MobiFlight/mobiflight-pcbs/README.md

# mobiflight-pcbs
PCBs and breakout boards, designed by the MobiFlight community:

* [MobiFlight Prototyping Board](prototyping-board/README.md)
* [MobiFlight Multiplexer Breakout Board](breakout-multiplexer/README.md)
* [MobiFlight MAX7219 Breakout System](max7219-breakout-system/README.md)
* [MobiFlight MAX7219 Adapter Board](max7219-adapter/README.md)
* [MobiFlight Dual Encoder Board](dual-encoder-board/README.md)
* [MobiFlight LED Driver Board](led-driver-board/README.md)
* [MobiFlight PicoMega Board](picomega/README.md)
* [MobiFlight PicoMicro Board](picomicro/README.md)
* [MobiFlight PicoNano Board](piconano/README.md)
If you are missing information, or if you found a bug, please [create a new issue here on GitHub](https://github.com/MobiFlight/mobiflight-pcbs/issues/new).
