MobiFlight/mobiflight-pcbs/dimmer-board/README.md

# Light dimmer board

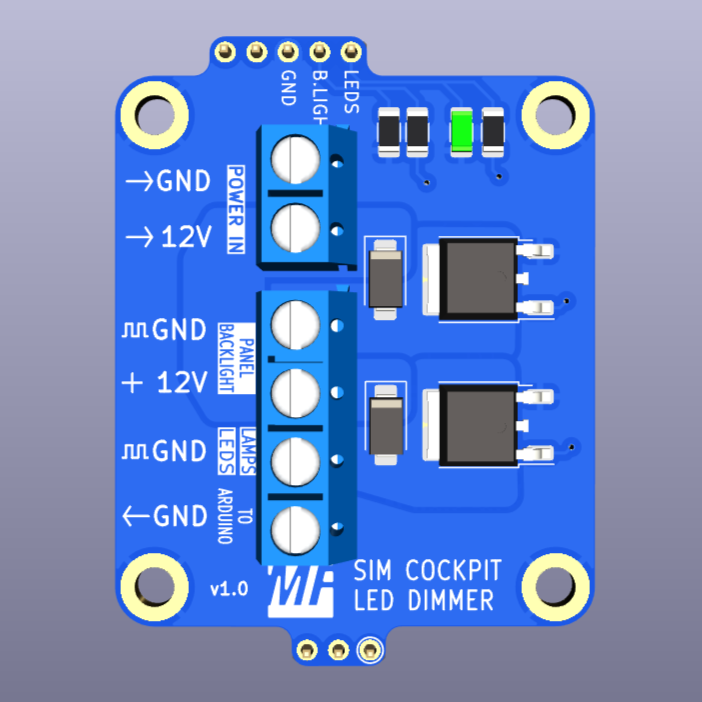
[picture p54: dimmer-board/dimmer-board.png]
Board image


This is a light dimmer board for backlight and cockpit lights, works as a shield on a full sized Arduino Mega, or standalone.
