MobiFlight/mobiflight-pcbs/dual-encoder-board/Encoder Dual Axis With Button EC11EBB24C03_2.png

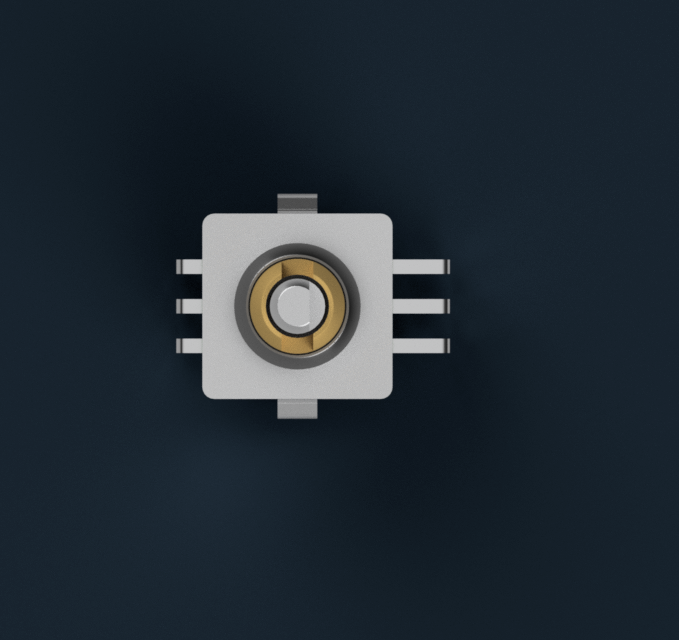
dual-encoder-board/Encoder Dual Axis With Button EC11EBB24C03_2.png
