MobiFlight/mobiflight-pcbs/dual-encoder-board/Encoder Single Axis With Button EC11M 25mm.png

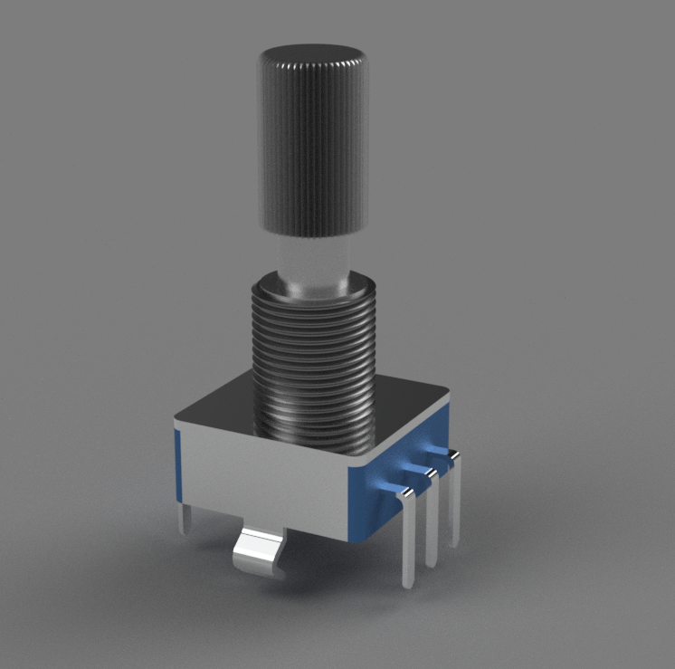
dual-encoder-board/Encoder Single Axis With Button EC11M 25mm.png
