MobiFlight/mobiflight-pcbs/max7219-breakout-digits/3-digits_0.36_Back.jpg

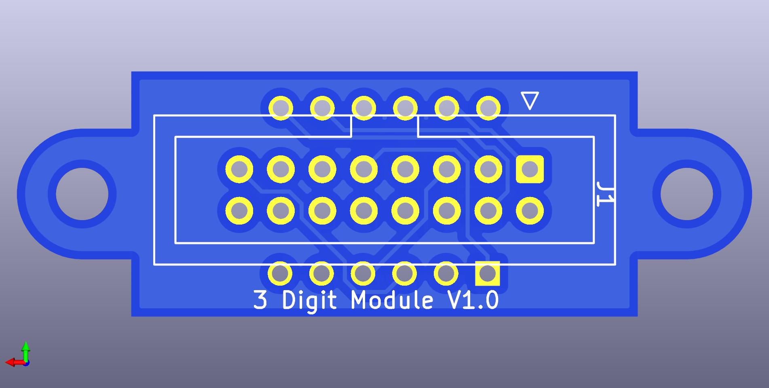
max7219-breakout-digits/3-digits_0.36_Back.jpg
