MobiFlight/mobiflight-pcbs/max7219-breakout-digits/4-digits_0.36_Back.jpg

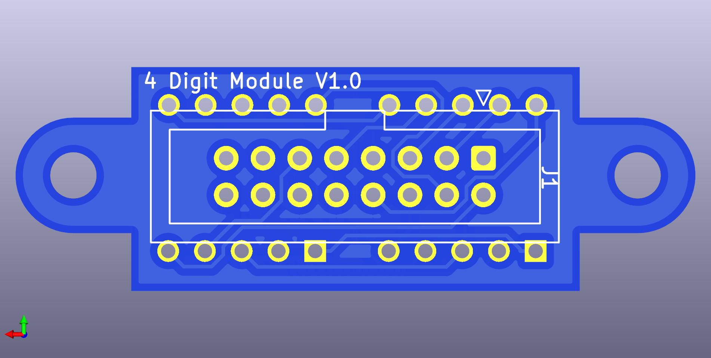
max7219-breakout-digits/4-digits_0.36_Back.jpg
