MobiFlight/mobiflight-pcbs/max7219-breakout-digits/5-digits_0.36_Front.jpg

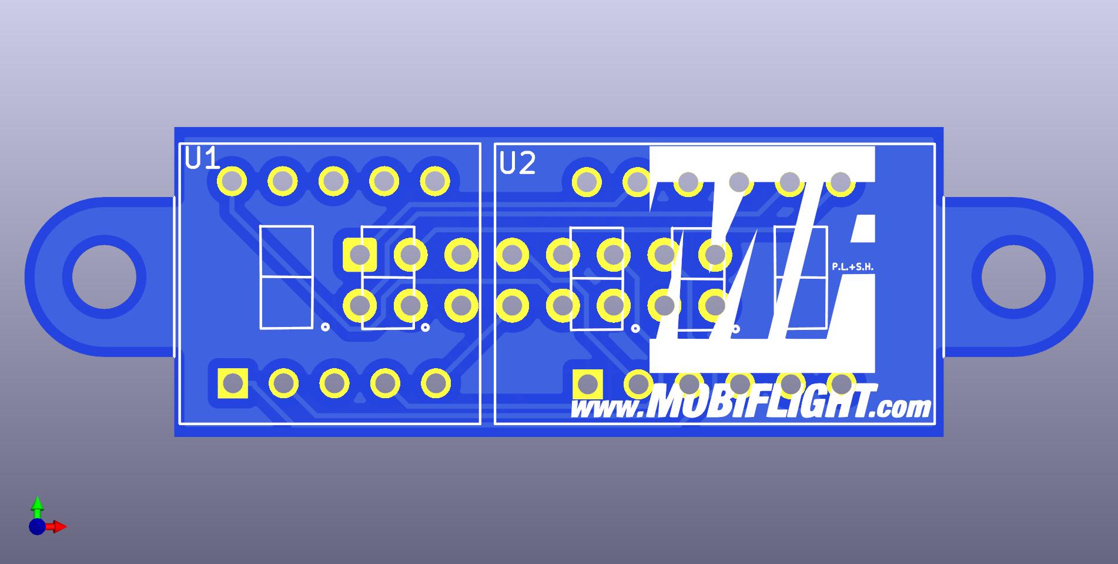
max7219-breakout-digits/5-digits_0.36_Front.jpg
