MobiFlight/mobiflight-pcbs/max7219-breakout-digits/6-digits_0.36_Back.jpg

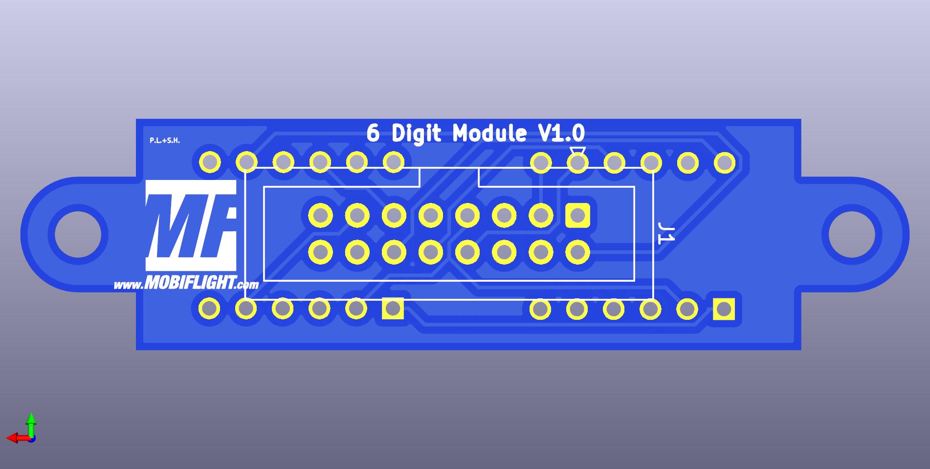
max7219-breakout-digits/6-digits_0.36_Back.jpg
