MobiFlight/mobiflight-pcbs/max7219-breakout-system/top.png

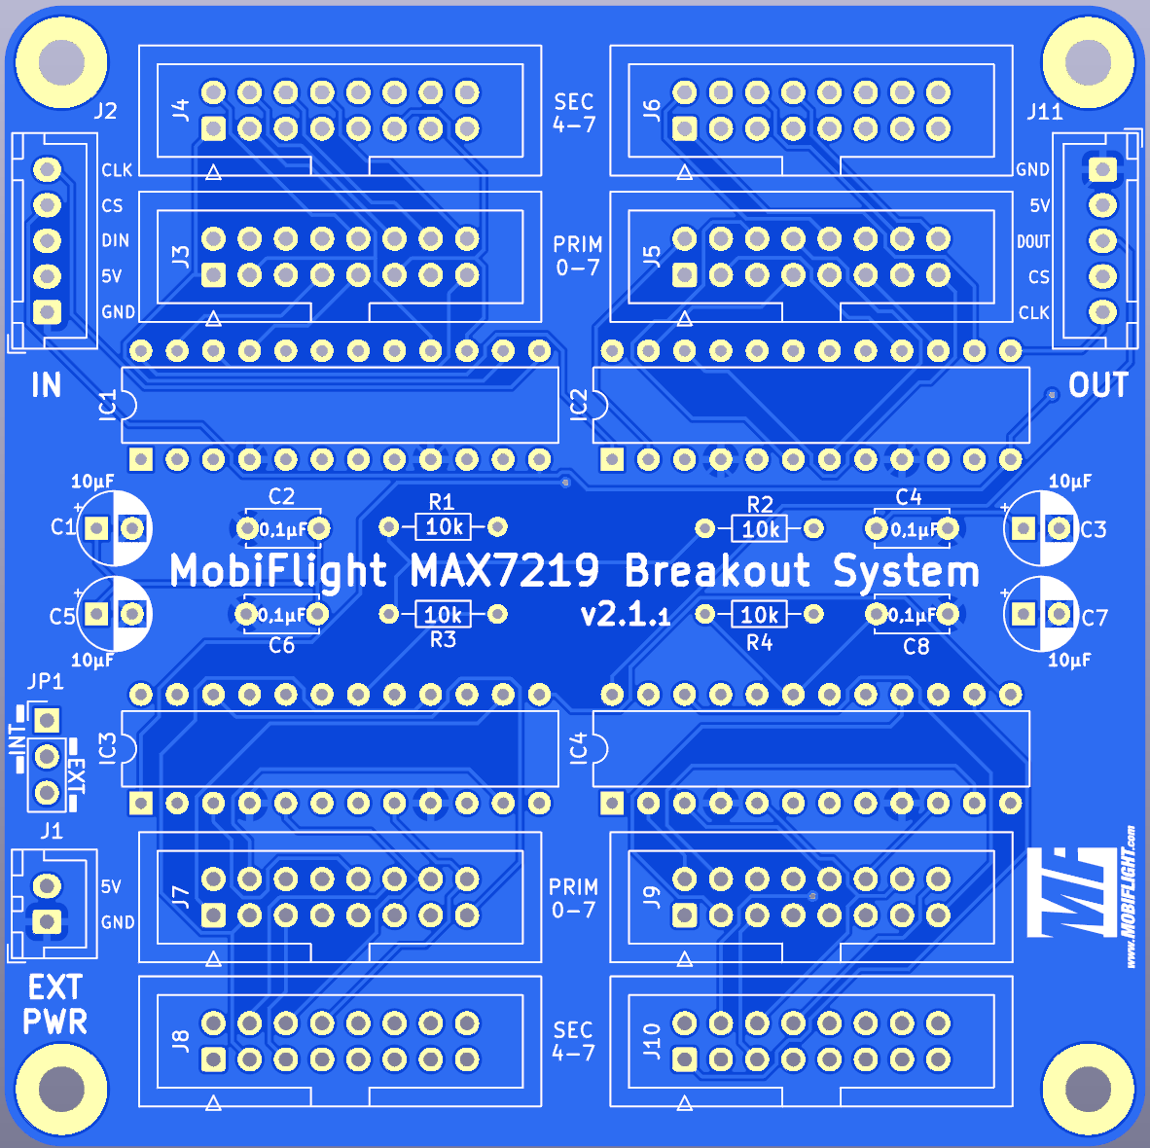
max7219-breakout-system/top.png
