MobiFlight/mobiflight-pcbs/rotary-switch-board/kicad-board-exports/rotary-switch-board-bottom.png

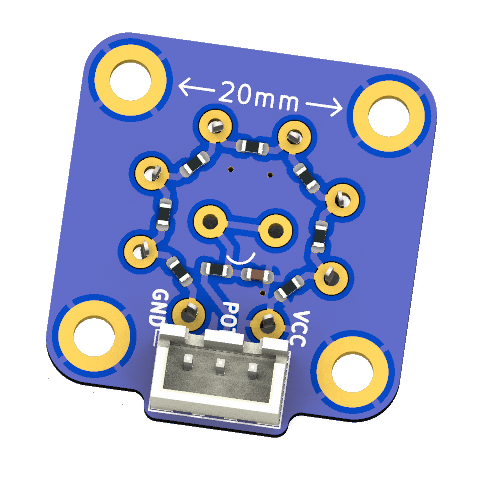
rotary-switch-board/kicad-board-exports/rotary-switch-board-bottom.png
