MobiFlight/mobiflight-pcbs/toggle-switch-board/kicad-board-exports/toggle-switch-board-bottom.png

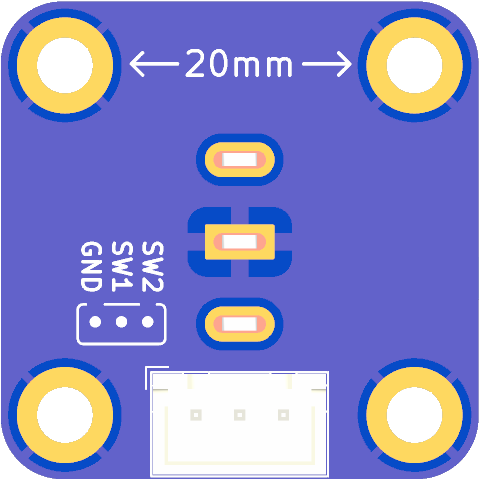
toggle-switch-board/kicad-board-exports/toggle-switch-board-bottom.png
