MobiFlight/mobiflight-pcbs/max7219-breakout-digits/breakout-components.png

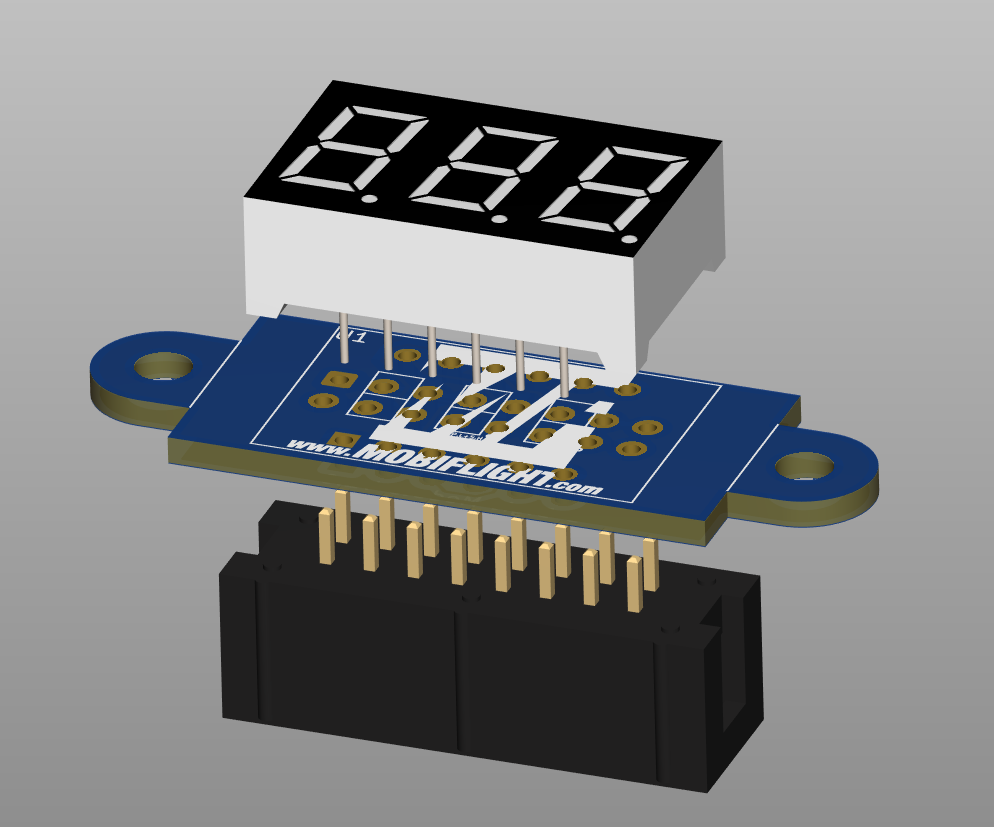
max7219-breakout-digits/breakout-components.png
