MobiFlight/mobiflight-pcbs/breakout-multiplexer/mf-breakout-74hc4067.step

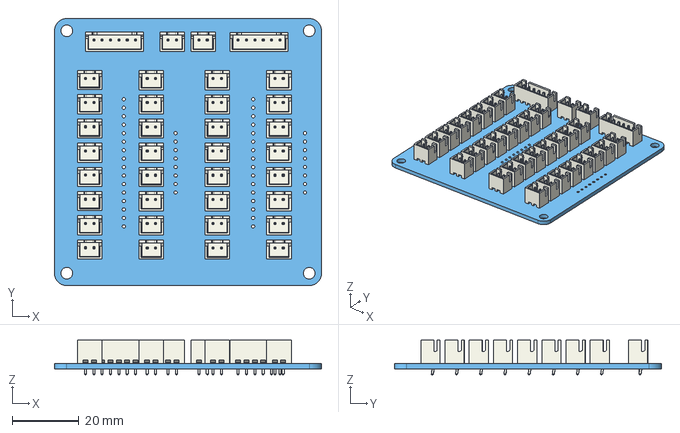
[picture p73: CAD file, 2023-02-22]
breakout-multiplexer/mf-breakout-74hc4067.step
80.0 x 80.0 x 10.4 mm
mf-breakout-74hc4067 PCB
