MobiFlight/mobiflight-pcbs/max7219-breakout-system/MAX7219-breakout-board.step

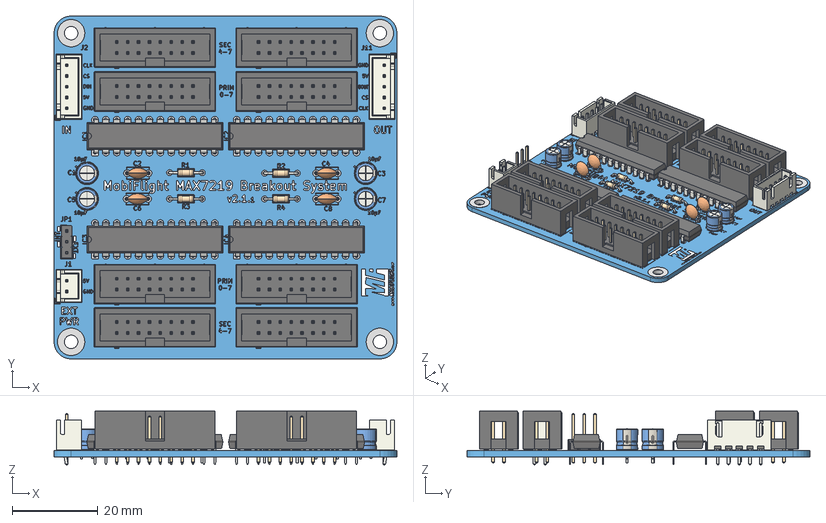
[picture p74: CAD file, 2026-05-14]
max7219-breakout-system/MAX7219-breakout-board.step
80.0 x 80.0 x 12.5 mm
CP_Radial_D5.0mm_P2.50mm x 4
JST_XH_B2B-XH-A_1x02_P2.50mm_Vertical
JST_XH_B5B-XH-A_1x05_P2.50mm_Vertical x 2
IDC-Header_2x08_P2.54mm_Vertical x 8
R_Axial_DIN0204_L3.6mm_D1.6mm_P7.62mm_Horizontal x 4
DIP-24_W7.62mm x 4
C_Disc_D5.0mm_W2.5mm_P5.00mm x 4
PinHeader_1x03_P2.54mm_Vertical
MAX7219-breakout-board_pad
MAX7219-breakout-board_silkscreen x 2
MAX7219-breakout-board_PCB
