MobiFlight/mobiflight-pcbs/mobiflight-library/3D-Files/T80-Z1.step

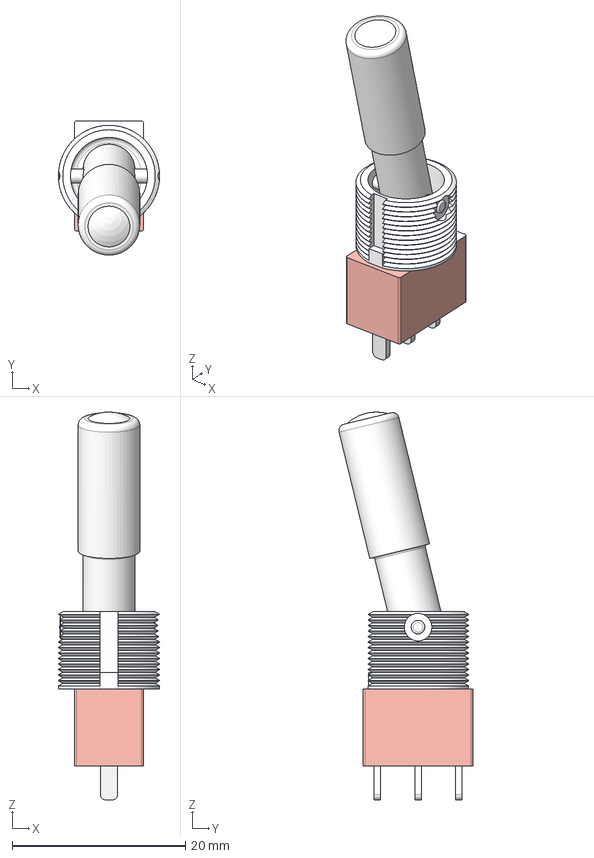
[picture p75: CAD file, 2026-07-28]
mobiflight-library/3D-Files/T80-Z1.step
11.7 x 15.5 x 44.8 mm
