MobiFlight/mobiflight-pcbs/potentiometer-board/potentiometer-board.step

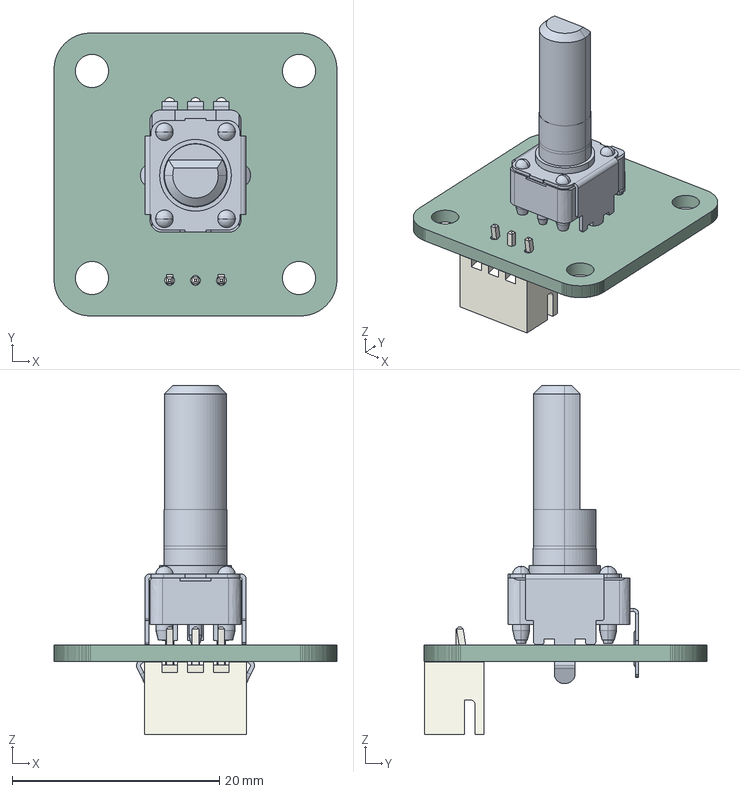
[picture p76: CAD file, 2025-02-23]
potentiometer-board/potentiometer-board.step
27.3 x 27.3 x 33.7 mm
Document
JST_B3B_XH_A
_autosave-potentiometer-board_PCB
