MobiFlight/mobiflight-pcbs/prototyping-board/case.stl

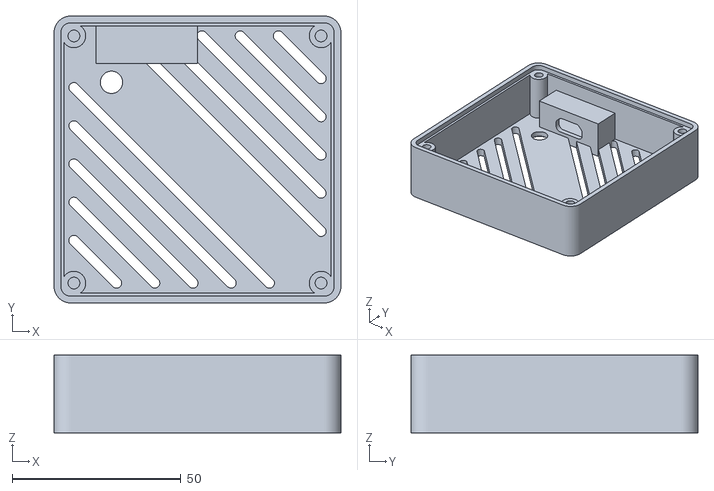
[picture p77: CAD file, 2023-01-19]
prototyping-board/case.stl
85.0 x 85.0 x 23.0
