MobiFlight/mobiflight-pcbs/rotary-switch-board/kicad-board-exports/rotary-switch-board.step

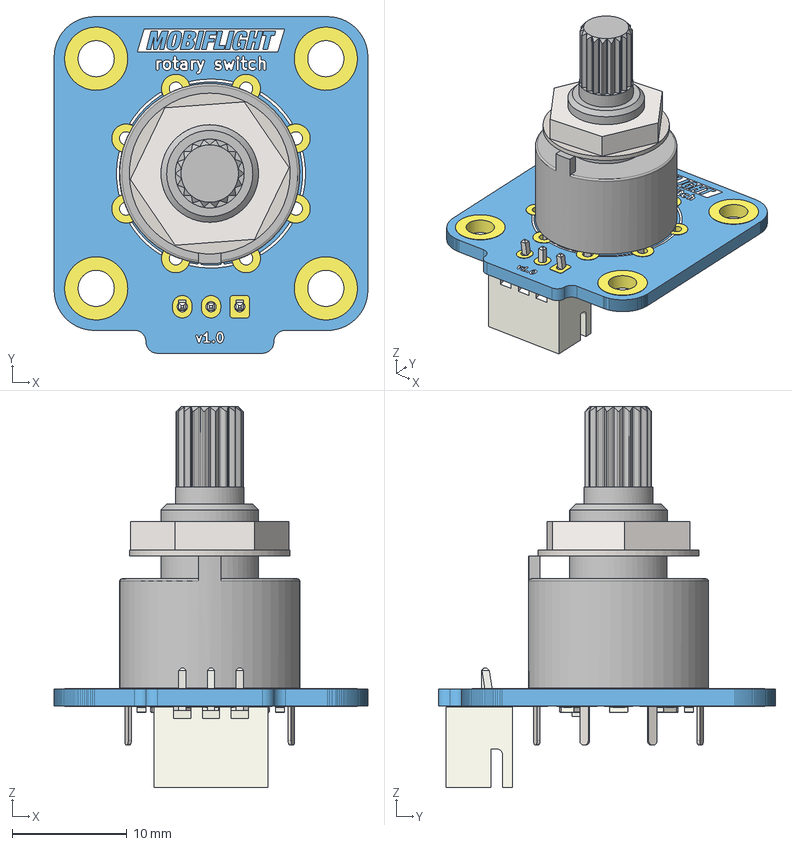
[picture p78: CAD file, 2026-05-16]
rotary-switch-board/kicad-board-exports/rotary-switch-board.step
27.3 x 29.3 x 33.2 mm
SR16 6 position
SR16 ٠ꢠ
SR16 Ġꫠ
JST_B3B_XH_A
R_0603_1608Metric x 8
C_0603_1608Metric
rotary-switch-board_copper
rotary-switch-board_silkscreen x 2
rotary-switch-board_PCB
