MobiFlight/mobiflight-pcbs/toggle-switch-board/kicad-board-exports/toggle-switch-board.step

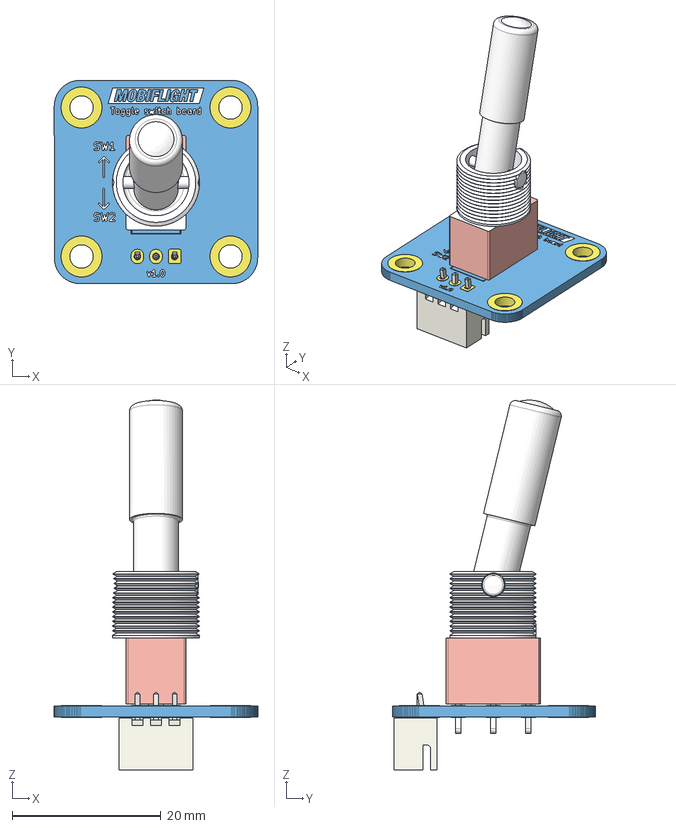
[picture p79: CAD file, 2026-07-28]
toggle-switch-board/kicad-board-exports/toggle-switch-board.step
27.3 x 27.3 x 49.7 mm
Switch
JST_B3B_XH_A
toggle-switch-board_copper
toggle-switch-board_silkscreen x 2
toggle-switch-board_PCB
