MobiFlight/mobiflight-pcbs/breakout-multiplexer/breakout-multiplexer-case.stl

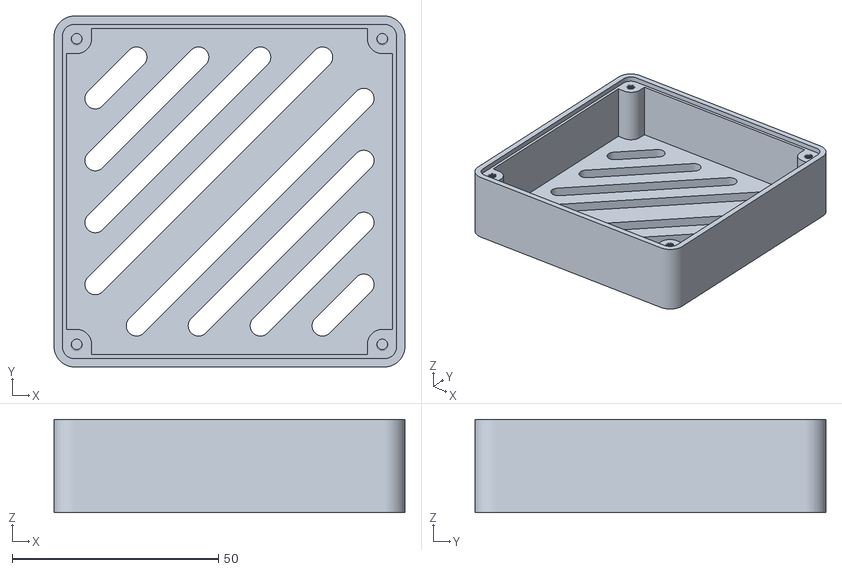
[picture p80: CAD file, 2022-11-13]
breakout-multiplexer/breakout-multiplexer-case.stl
85.0 x 85.0 x 22.6
