MobiFlight/mobiflight-pcbs/mobiflight-library/3D-Files/X27-168.step

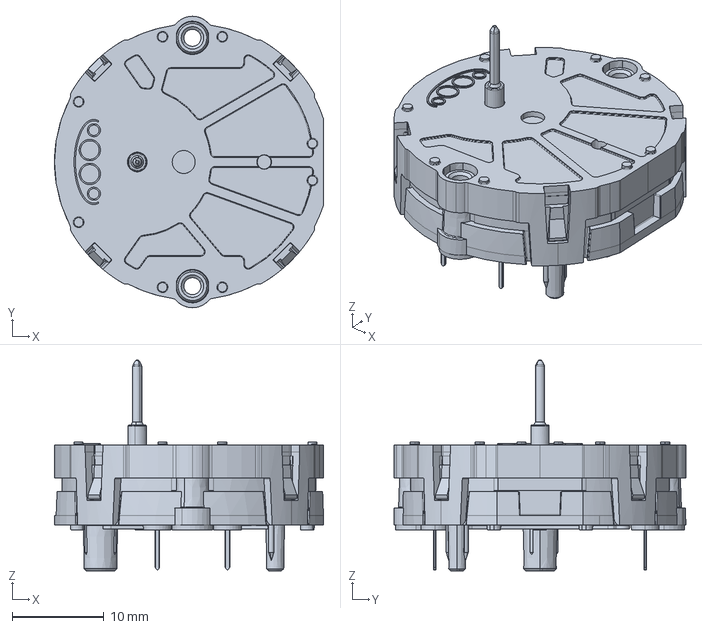
[picture p81: CAD file, 2026-05-16]
mobiflight-library/3D-Files/X27-168.step
29.3 x 31.7 x 22.9 mm
