MobiFlight/mobiflight-pcbs/potentiometer-board/RK09K1130AH1.STEP

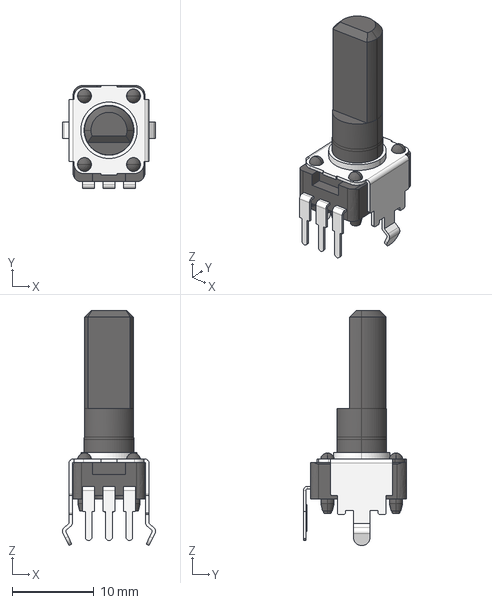
[picture p82: CAD file, 2025-02-23]
potentiometer-board/RK09K1130AH1.STEP
11.4 x 12.7 x 28.8 mm
