MobiFlight/mobiflight-pcbs/prototyping-board/cube-base-adapter.stl

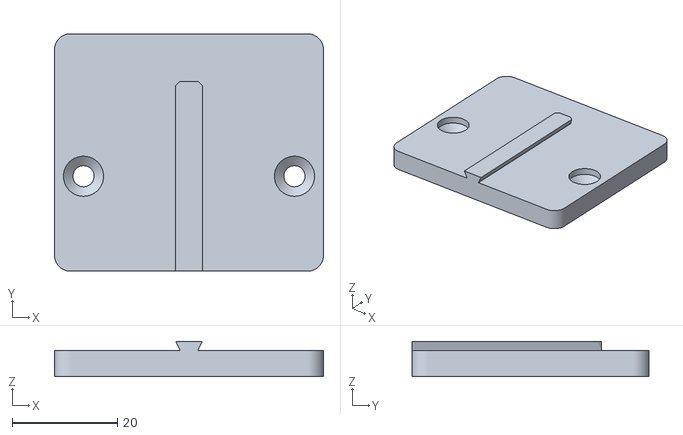
[picture p83: CAD file, 2022-11-13]
prototyping-board/cube-base-adapter.stl
51.0 x 45.0 x 6.72
