MobiFlight/mobiflight-pcbs/mobiflight-library/3D-Files/SR16.STEP

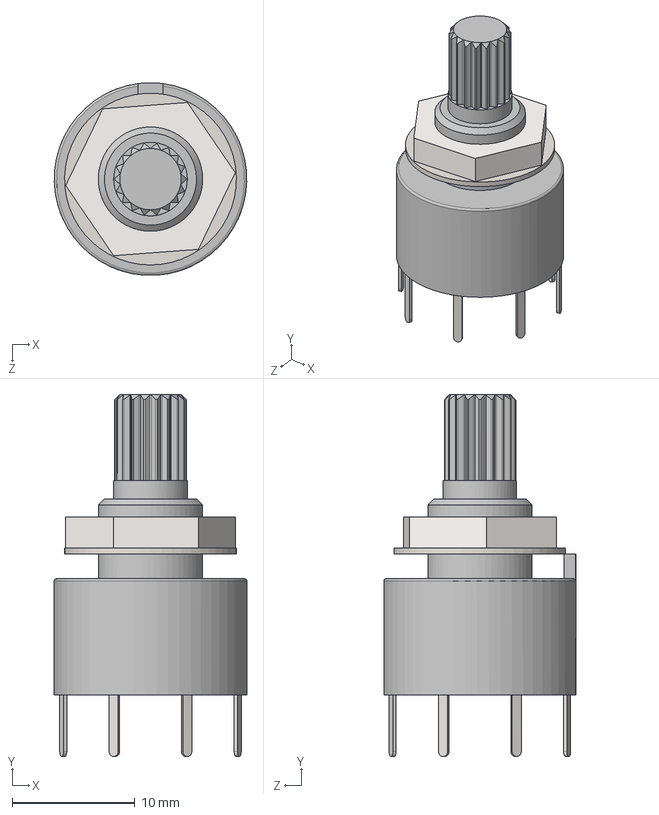
[picture p84: CAD file, 2026-05-16]
mobiflight-library/3D-Files/SR16.STEP
15.7 x 29.5 x 15.7 mm
SR16 6 position
SR16 ﾘ琺矜
SR16 Ãàéêà
