MobiFlight/mobiflight-pcbs/mobiflight-library/3D-Files/JST_XH_B2B-XH-A_1x02_P2.50mm_Vertical_red.step

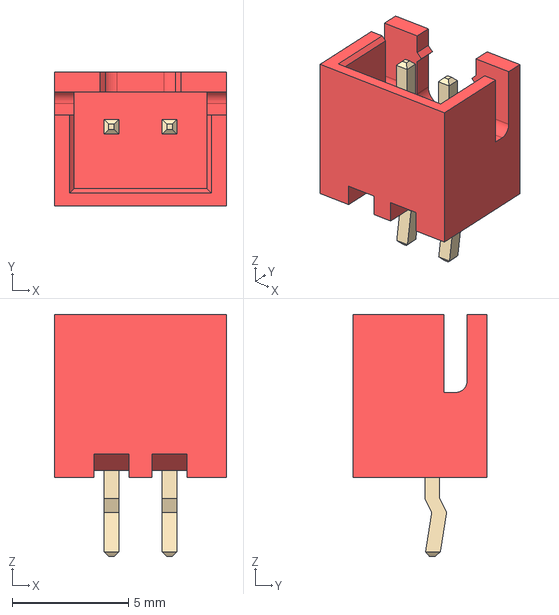
[picture p85: CAD file, 2026-05-14]
mobiflight-library/3D-Files/JST_XH_B2B-XH-A_1x02_P2.50mm_Vertical_red.step
7.40 x 5.75 x 10.4 mm
