MobiFlight/mobiflight-pcbs/mobiflight-library/3D-Files/Coil_RP2350_AOTA-B201610S3R3-101-T.step

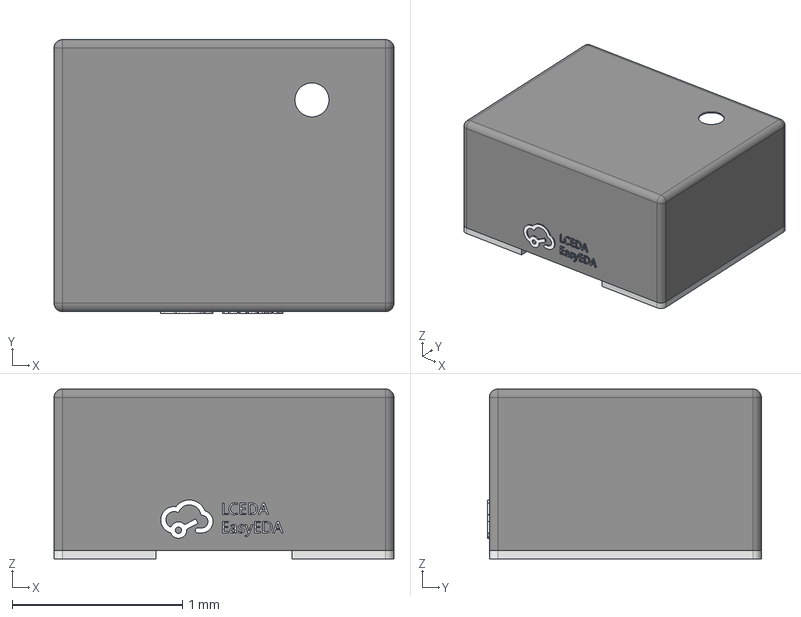
[picture p86: CAD file, 2025-10-19]
mobiflight-library/3D-Files/Coil_RP2350_AOTA-B201610S3R3-101-T.step
2.00 x 1.61 x 1 mm
