MobiFlight/mobiflight-pcbs/mobiflight-library/3D-Files/RP2350B-QFN80.step

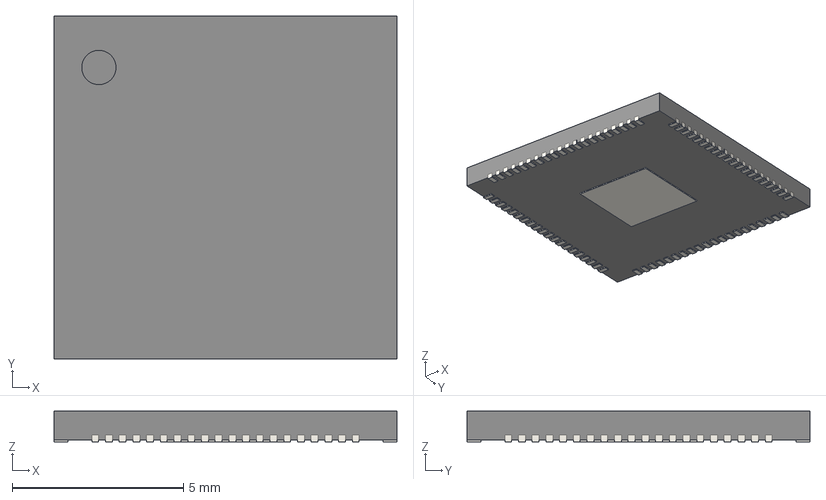
[picture p87: CAD file, 2025-10-19]
mobiflight-library/3D-Files/RP2350B-QFN80.step
10.0 x 10.0 x 0.9 mm
