MobiFlight/mobiflight-pcbs/mobiflight-library/3D-Files/RP2350A-QFN60.step

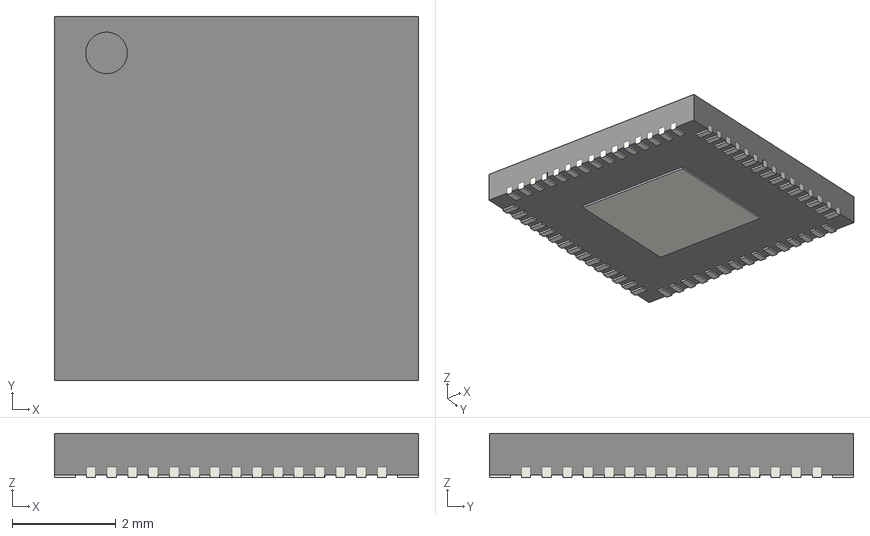
[picture p88: CAD file, 2025-10-19]
mobiflight-library/3D-Files/RP2350A-QFN60.step
7.00 x 7.00 x 0.85 mm
