MobiFlight/mobiflight-pcbs/mobiflight-library/3D-Files/Potentiometer_Bourns_3314j-1-103e.stp

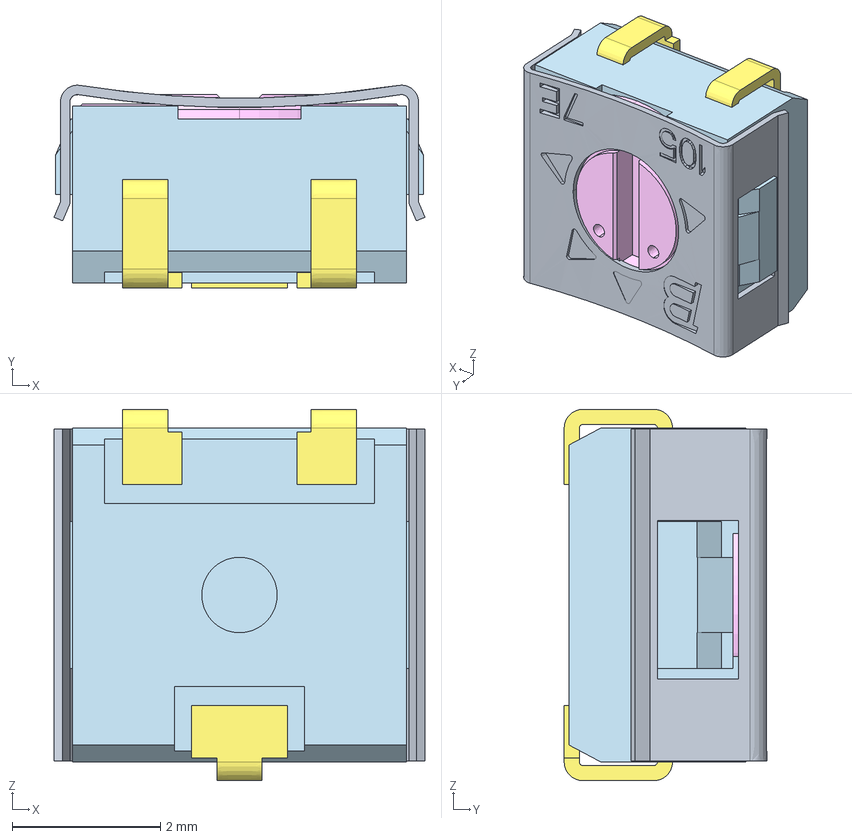
[picture p89: CAD file, 2025-10-19]
mobiflight-library/3D-Files/Potentiometer_Bourns_3314j-1-103e.stp
5.00 x 2.73 x 5.00 mm
