MobiFlight/mobiflight-pcbs/mobiflight-library/3D-Files/USB_C_Receptacle_USB2.0_16P.step

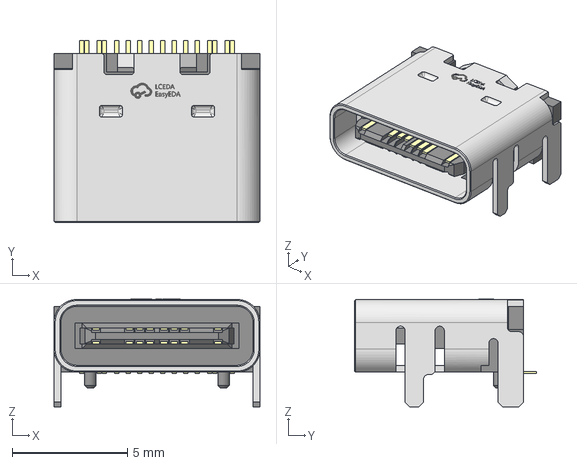
[picture p90: CAD file, 2025-10-19]
mobiflight-library/3D-Files/USB_C_Receptacle_USB2.0_16P.step
8.94 x 7.90 x 4.67 mm
