MobiFlight/mobiflight-pcbs/mobiflight-library/3D-Files/SMD Button K2-1808SN-A4SW-01.step

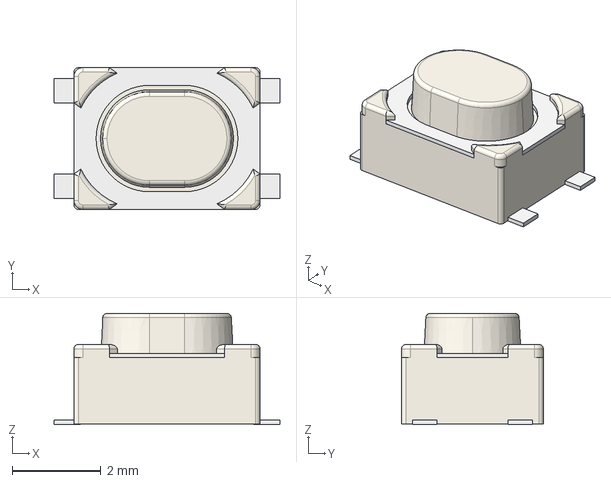
[picture p91: CAD file, 2025-10-19]
mobiflight-library/3D-Files/SMD Button K2-1808SN-A4SW-01.step
5.10 x 3.20 x 2.51 mm
