MobiFlight/mobiflight-pcbs/mobiflight-library/3D-Files/SMD Button XKB_TS-1187A-B-A-B.step

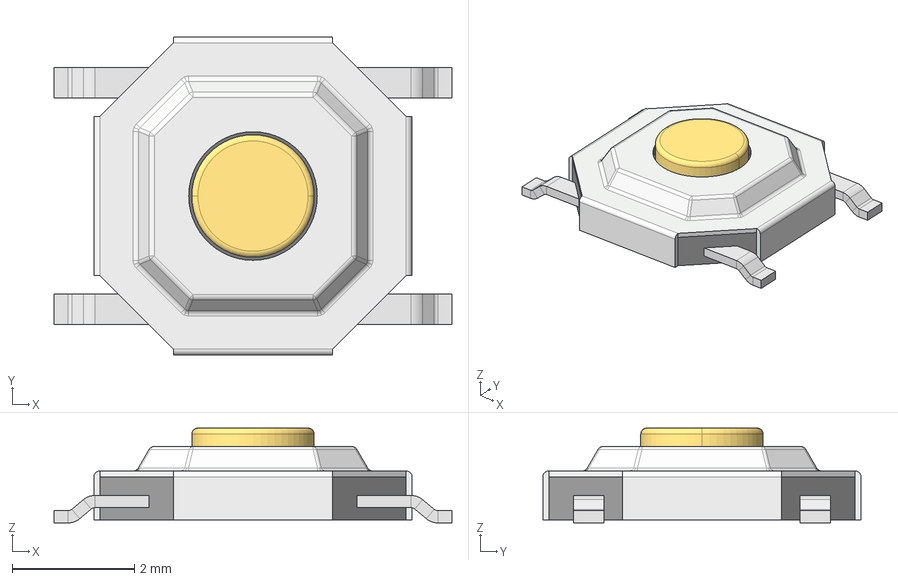
[picture p92: CAD file, 2025-10-19]
mobiflight-library/3D-Files/SMD Button XKB_TS-1187A-B-A-B.step
6.50 x 5.20 x 1.55 mm
