MobiFlight/mobiflight-pcbs/mobiflight-library/3D-Files/Potentiometer_Bochen_3362P-1-502.step

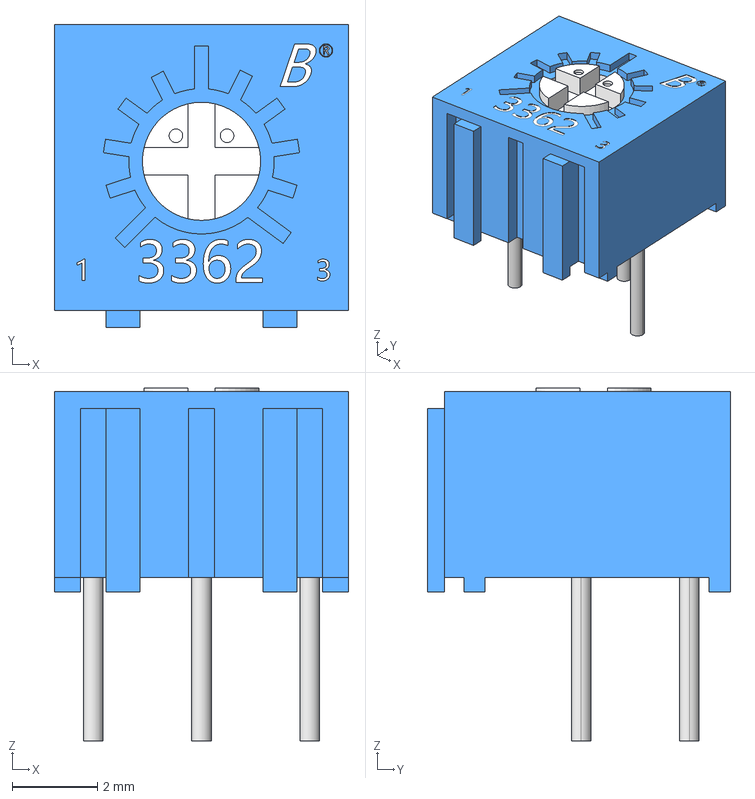
[picture p93: CAD file, 2025-10-19]
mobiflight-library/3D-Files/Potentiometer_Bochen_3362P-1-502.step
6.90 x 7.10 x 8.28 mm
