MobiFlight/mobiflight-pcbs/mobiflight-library/3D-Files/Switch Rotary RS16.step

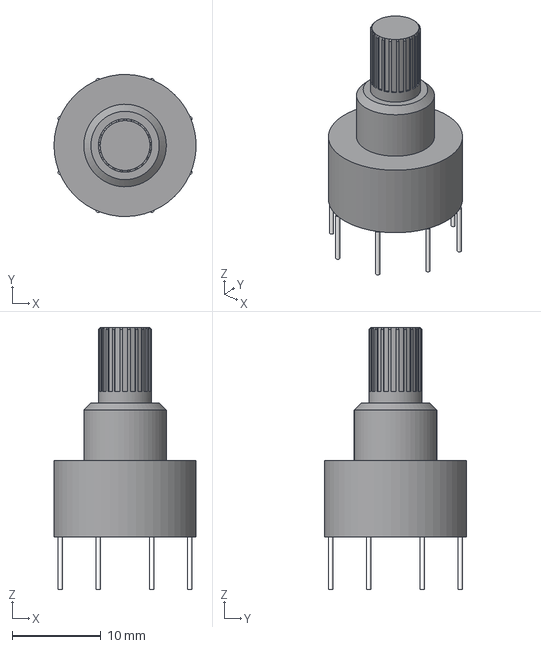
[picture p94: CAD file, 2025-02-23]
mobiflight-library/3D-Files/Switch Rotary RS16.step
16.0 x 16.0 x 29.5 mm
