MobiFlight/mobiflight-pcbs/mobiflight-library/3D-Files/Switch Toggle 2p with LED 12V.step

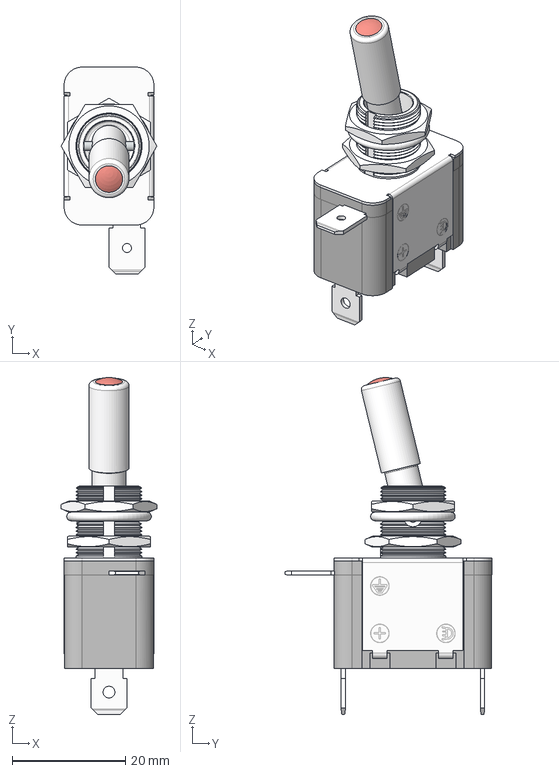
[picture p95: CAD file, 2025-02-23]
mobiflight-library/3D-Files/Switch Toggle 2p with LED 12V.step
17.0 x 36.6 x 59.6 mm
