MobiFlight/mobiflight-pcbs/mobiflight-library/3D-Files/Encoder Single Axis With Button EC11M 25mm.step

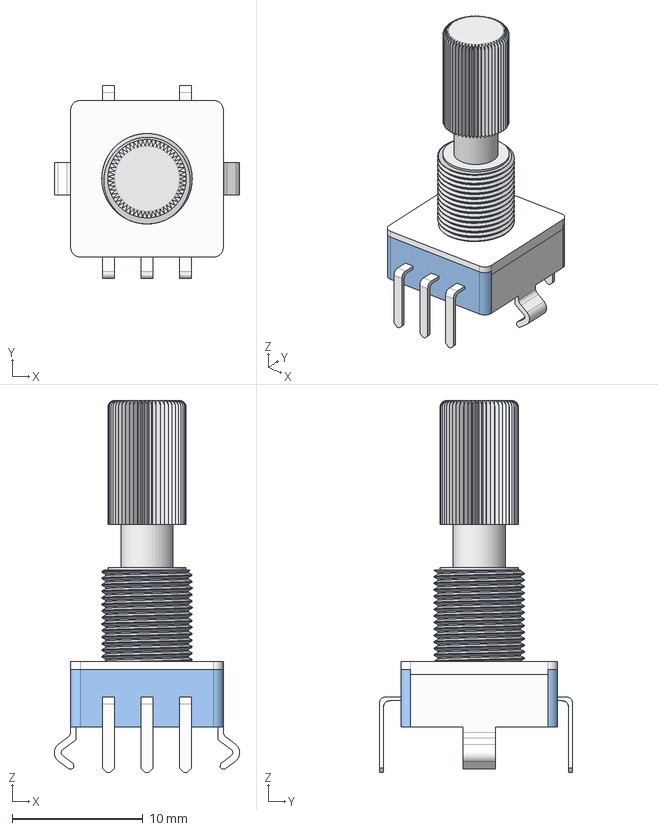
[picture p96: CAD file, 2025-02-23]
mobiflight-library/3D-Files/Encoder Single Axis With Button EC11M 25mm.step
14.2 x 14.8 x 28.5 mm
