MobiFlight/mobiflight-pcbs/mobiflight-library/3D-Files/Encoder Dual Axis With Button EC11EBB24C03.step

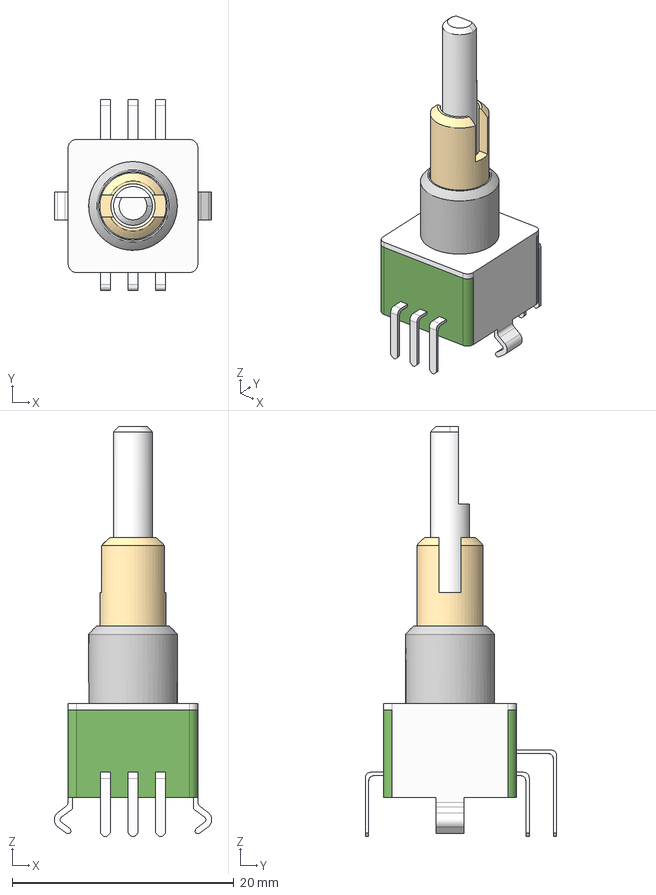
[picture p97: CAD file, 2025-02-23]
mobiflight-library/3D-Files/Encoder Dual Axis With Button EC11EBB24C03.step
14.2 x 17.3 x 37.0 mm
