MobiFlight/mobiflight-pcbs/mobiflight-library/3D-Files/Switch Toggle 2p 3p 12mm.step

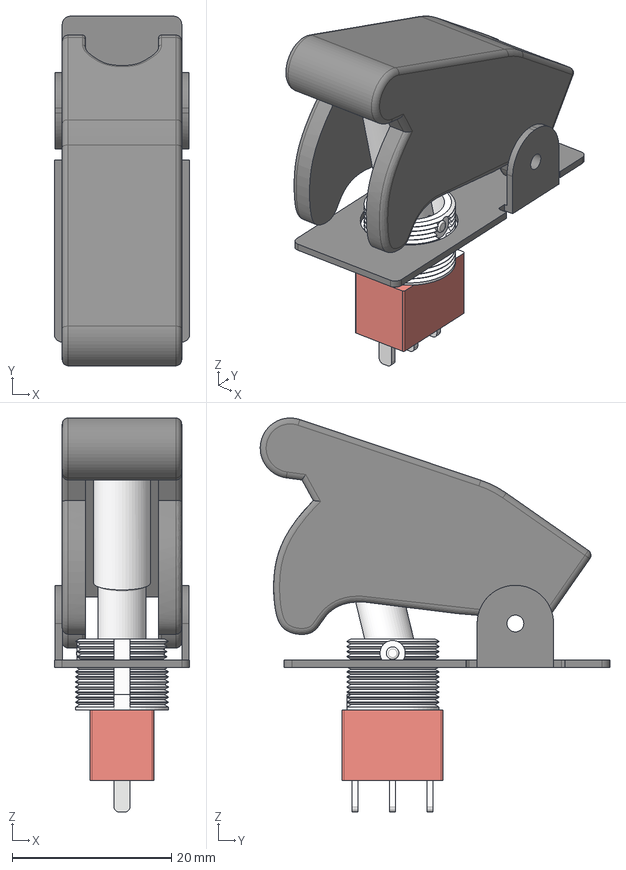
[picture p98: CAD file, 2025-02-23]
mobiflight-library/3D-Files/Switch Toggle 2p 3p 12mm.step
17.0 x 43.9 x 49.5 mm
