MobiFlight/mobiflight-pcbs/(list of files, cad)

Other CAD files:
max7219-breakout-system/max7219-breakout-system.step
mobiflight-library/3D-Files/Degson_ScrewTerminal_DG301-5.0-02.stp
mobiflight-library/3D-Files/Degson_ScrewTerminal_DG301-5.0-04.stp
