MobiFlight/mobiflight-pcbs/(threads)

Thread 4 (2023-05-05):

Prototyping Board - labels are not correct

DocMoebiuz, 2023-05-05:
The servo silkscreen labels are not correct
* Servo 1&2 - DIN and GND have to switch
* ShiftRegister 1&2 - Rotate GND 180 degrees
* Pot 1-3 - Rotate GND 180 degrees
* Pot 1-3 - Rotate Pin1 180 degrees

Closed 2023-06-23.

Thread 5 (2023-05-29):

Prototyping board - LED 06 is not PWM

DocMoebiuz, 2023-05-29:
The LED06 pin is connected to pin22 which doesn't support PWM.

Board v2.0

Closed 2023-06-23.

Thread 17 (2023-08-12):

Prototyping Board - minor label improvements

MobiFlight-Admin, 2023-08-12:
- LED1 PWM, LED6 PWM - the text doesn't fit the space, remove PWM on second label
- Switch 6 - should read ON-ON, instead of ON-OFF
- Backside labels wrong orientation
  - LCD1 & 2: D21/D20,
  - 7-Segment: D23/D25/D27
