MobiFlight/mobiflight-pcbs/toggle-switch-board/kicad-board-exports/toggle-switch-board-schematic.pdf

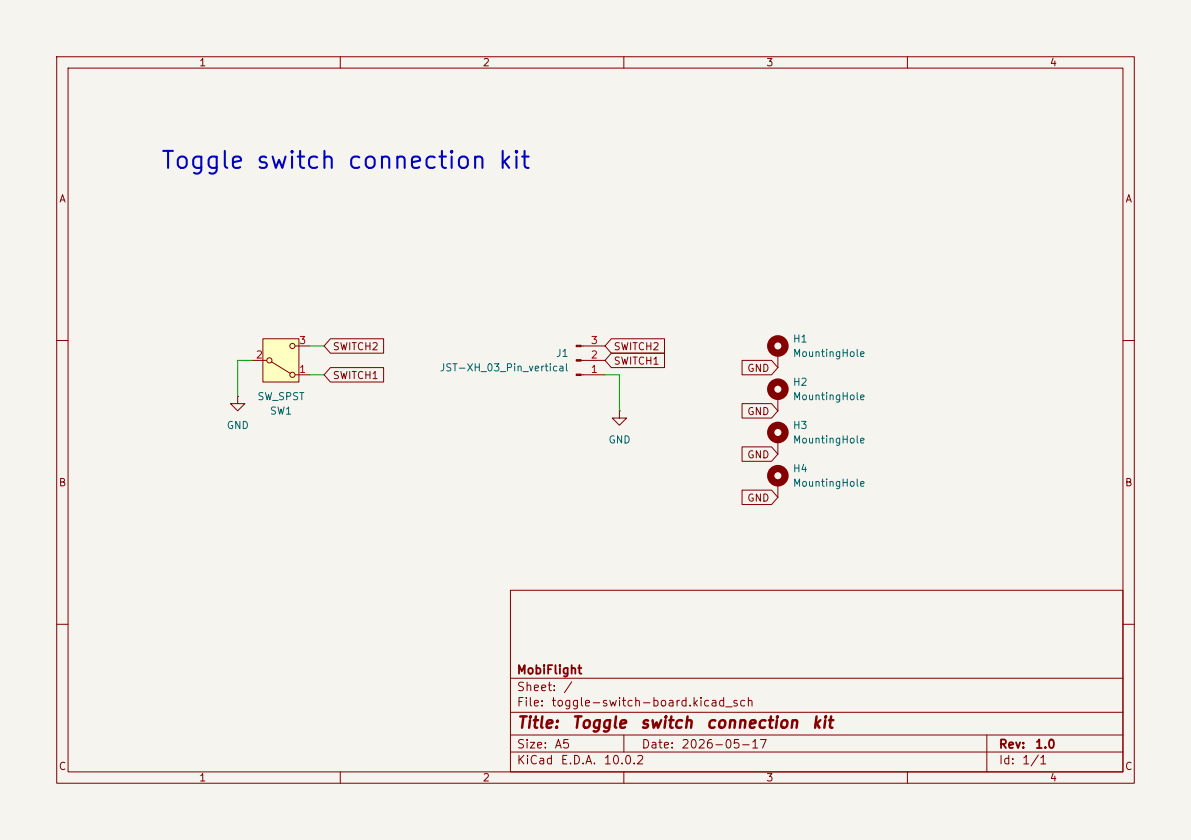
[picture p104: page 1]

SWITCH1 Toggle switch connection kit

Sheet: /
File: toggle-switch-board.kicad_sch
Title: Toggle switch connection kit

Size: A5 | Rev: 1.0 | C Date: 2026-05-17
KiCad E.D.A. 10.0.2 | Id: 1/1
