MobiFlight/mobiflight-pcbs/rotary-switch-board/kicad-board-exports/rotary-switch-board-schematic.pdf

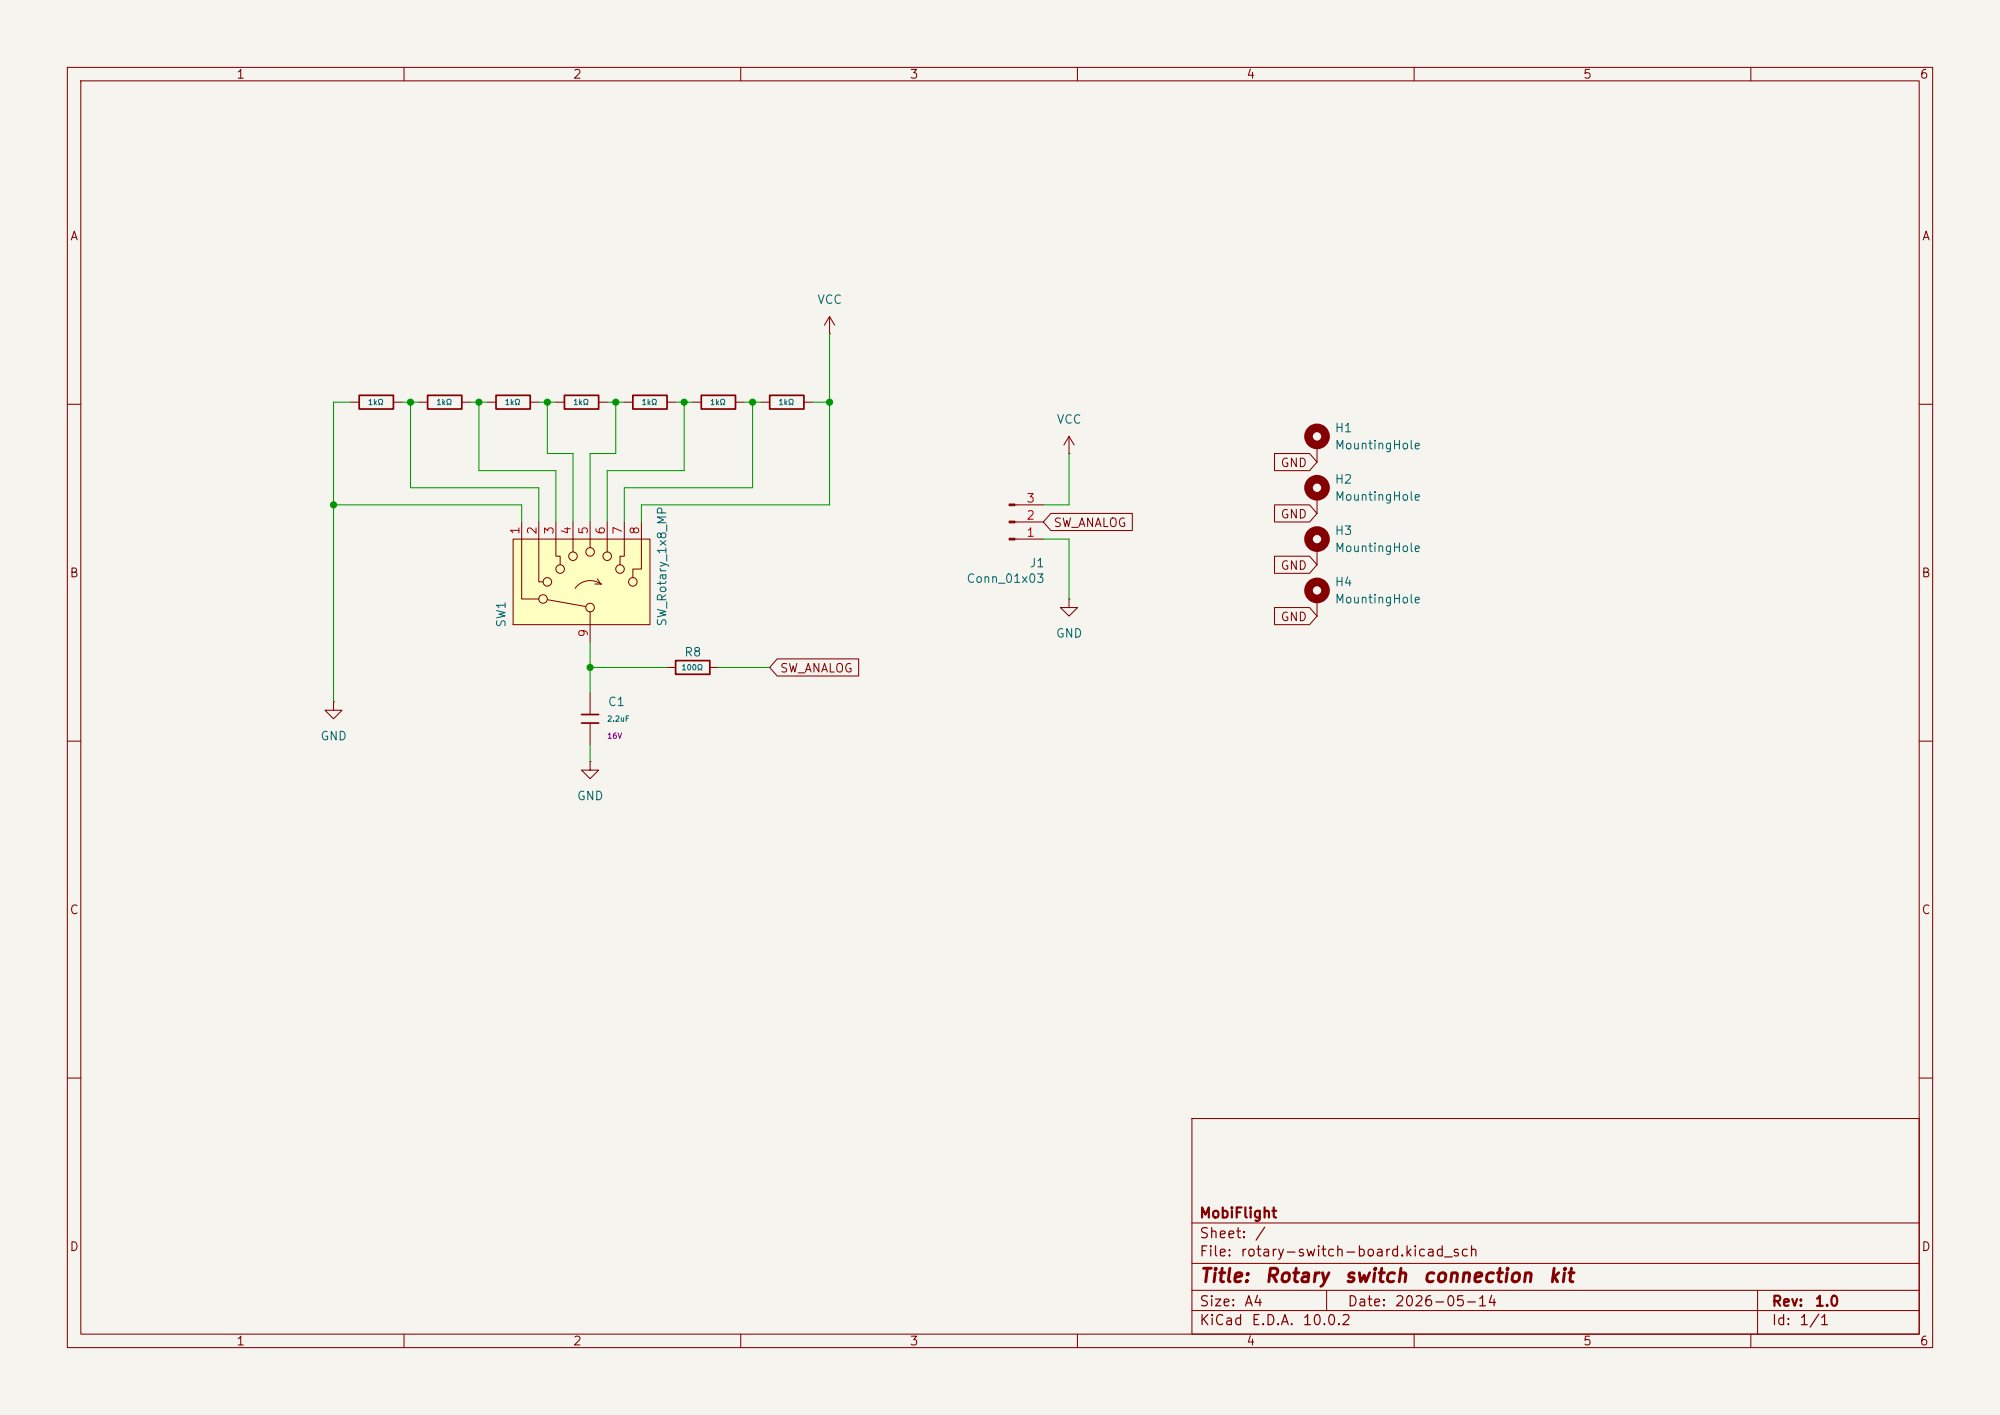
[picture p105: page 1]

MobiFlight
Sheet: /
File: rotary-switch-board.kicad_sch
Title: Rotary switch connection kit

Size: A4 | Rev: 1.0
KiCad E.D.A. 10.0.2 | Id: 1/1
