MobiFlight/mobiflight-pcbs/(commit log)

2022-11-07 added mfmc and schematic
2022-11-13 added gitignore file, ignore KiCad auto-generated files
2022-11-13 added case STL for the base adapter
    [cube-base-adapter.stl]
2022-11-13 added breakout multiplexer information
    [breakout-multiplexer-case.stl]
2022-11-13 added link to STL file
2022-11-26 added dual encoder board kicad project files
    [dual-encoder-board.kicad_pcb, dual-encoder-board.kicad_sch]
2022-11-27 mention 8mm standoffs
2022-11-27 added multiplexer breakout board kicad files
    [mf-breakout-74hc4067.kicad_pcb, mf-breakout-74hc4067.kicad_sch]
2022-12-09 Added Dual Encoder Board to the Start page README
2023-01-04 updated config for v1.4 of the board, and also added multiplexer config.
2023-01-19 Added the cube adapter changes
    [case.stl, cube-adapter.kicad_pcb, cube-adapter.kicad_sch]
2023-01-19 Added kicad files for max7219 and updated the pics
    [MAX7219-breakout-board.kicad_pcb, MAX7219-breakout-board.kicad_sch]
2023-02-22 Updated the multiplexer breakout board to v1.2 with better labels, and a QR code
    [mf-breakout-74hc4067.kicad_pcb, mf-breakout-74hc4067.kicad_sch, mf-breakout-74hc4067.step]
2023-02-22 updated label on PCB to v1.2
    [mf-breakout-74hc4067.kicad_pcb]
2023-03-02 corrected mounting hole position
    [cube-adapter.kicad_pcb]
2023-03-02 multiplexer board v1.4 changes
    [mf-breakout-74hc4067.kicad_pcb, mf-breakout-74hc4067.kicad_sch]
2023-03-02 max7219 breakout board - changed color to blue
    [MAX7219-breakout-board.kicad_pcb]
2023-03-21 sync the jst connector type between schema and pcb
    [dual-encoder-board.kicad_sch]
2023-03-21 Updates to pcb: - centered the board outline to mounting holes, was slightly off - moved the pin labels farther from JST's to avoid DRC errors - change the unconnected pin 4 of outer knob to just "X"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
    [dual-encoder-board.kicad_pcb]
2023-03-25 changes for version 2.0
    [MAX7219-breakout-board.kicad_pcb, MAX7219-breakout-board.kicad_sch]
2023-03-25 v2.0 of cube adapter
    [cube-adapter.kicad_pcb, cube-adapter.kicad_sch]
2023-05-29 Updated readme for protptyping board to v2.0
2023-05-29 Prototyping board - Updated pictures and schematic
    [cube-adapter.kicad_sch]
2023-05-29 updated the board name in mfmc file
2023-06-16 Moved button pin to outer encoder connector (#9)
    * updated button pin to outer encoder connector so it works for single encoders also
    * updated button pin to outer encoder connector so it works for single encoders also
    [dual-encoder-board.kicad_pcb, dual-encoder-board.kicad_sch]
2023-06-23 switch led pin and fix labels (#6)
    * switch led pin and fix labels
    * Updated the mfmc file for 2.1
    * created 2.0 version mfmc
    * update board views and schematics
    * created the multiplexer board config
    [cube-adapter.kicad_pcb, cube-adapter.kicad_sch]
2023-06-24 Renamed the cube-adapter folder
    [case.stl, cube-adapter.kicad_pcb, cube-adapter.kicad_sch, cube-base-adapter.stl]
2023-06-30 updated the encoder net names (#11)
    [dual-encoder-board.kicad_pcb, dual-encoder-board.kicad_sch]
2023-06-30 routed the inner a and b traces inside the ground pads (#12)
    [dual-encoder-board.kicad_pcb]
2023-07-03 renamed the files to prototype-board* (#14)
    [prototyping-board.kicad_pcb, prototyping-board.kicad_sch]
2023-07-03 deleted old files which were not delete on PR
    [cube-adapter.kicad_pcb, cube-adapter.kicad_sch]
2023-08-12 Updated labels to perfection :-) (#13)
    [dual-encoder-board.kicad_pcb]
2024-01-07 added light dimmer board (#20)
    * added light dimmer board
    * Create README.md
    * Added the pdf manual
    Added manual for dimmer board.
    [dimmer-board.kicad_pcb, dimmer-board.kicad_sch]
2024-05-05 label improvements (#23)
    [prototyping-board.kicad_pcb, prototyping-board.kicad_sch]
2024-11-03 Update README.md (#26)
    * Update README.md
    Contains text and images from https://github.com/MobiFlight/mobiflight-pcbs/pull/25
2024-12-04 mounting holes are 72mm apart (#28)
    * mounting holes are 72mm apart
    * Fixed all warnings, qr code, and jumper label
    [MAX7219-breakout-board.kicad_pcb, MAX7219-breakout-board.kicad_sch]
2025-02-23 Use boomelect XH connectors (#29)
    [prototyping-board.kicad_pcb, prototyping-board.kicad_sch]
2025-02-23 MAX7219 breakout digit board README (#21)
    * added readme for breakout digits
    * fixed shop url for breakout digit board
    * changed INFO block to IMPORTANT
    * corrected some minor typos
    ---------
2025-02-23 added potentiometer board (#30)
    [RK09K1130AH1.STEP, potentiometer-board.kicad_pcb, potentiometer-board.kicad_sch, potentiometer-board.step]
2025-02-23 STEP files of our popular components (#18)
    * STEP file of Dual Axis Encoder added
    * added new components
    * added new components
    [Encoder Dual Axis With Button EC11EBB24C03.step, Encoder Single Axis With Button EC11M 25mm.step, Switch Rotary RS16.step, Switch Toggle 2p 3p 12mm.step, Switch Toggle 2p with LED 12V.step]
2025-05-05 35 standardize mux (#36)
    * fixed mounting holes and track width
    * Add footprints to library
    * Updated 74HC4067 footprints, track size
    * not sure :D
    [mf-breakout-74hc4067.kicad_pcb, mf-breakout-74hc4067.kicad_sch]
2025-07-28 add template for schematic and board (#40)
    [mobiflight_template.kicad_pcb, mobiflight_template.kicad_sch]
2025-09-02 LED Driver board V1.1 (#38)
    * without production files
    * add jlcpcb folder in gitignore
    * add missing order numbers in schematic
    * BOM and CPL not required
    * add readme
    * add Dim description, board configuration
    * use correct names from prototyping board, direct download of board config
    * add wiring diagram
    * update wirung diagram
    * fixed wrong color order
    * add wiring diagram for direct connection
    * without production files
    * add jlcpcb folder in gitignore
    * add missing order numbers in schematic
    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
    [LED-driver-Board.kicad_pcb, LED-driver-Board.kicad_sch]
2025-09-05 Add input shifter board V1.1 (#39)
    * add input shifter board
    * add part numbers for all components, rename sheet with active parts
    * ignore jlcpcb folder
    * without BOM and CPL files
    * add 1st version of readme
    * fixed wrong name for bottom picture
    * fixed wrong name for schematic leds
    * fixed wrong shifter type
    * delete not required .wrl file
    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
    [LEDs.kicad_sch, active_parts.kicad_sch, input-shifter-board.kicad_pcb, input-shifter-board.kicad_sch]
2025-09-05 Routing is still pending
    [mf-breakout-74hc4067-smd.kicad_pcb, mf-breakout-74hc4067-smd.kicad_sch]
2025-09-10 New Poti, protection for reversed input voltage (#41)
    * changed footprint of potis, add diode
    * add 3D file for Poti
    * fixed wrong position of D1
    * fixed wrong qr code, numbering LEDs start at 0
    * update top and bottom picture
    * update readme to numbering starting with 0
    * fixed wrong order number for potis, markings optimized
    * potis from MF library
    * adding diagram for current setting
    * fixed wrong color of PWR connector
    * better routing, better positioning of pull down Rs
    [LED-driver-Board.kicad_pcb, LED-driver-Board.kicad_sch]
2025-09-23 Add diode to supply LED's from Arduino board (#42)
    * add diode to supply LED's from Arduino board
    * update readme
    * fixed wrong LED numbering in Readme
    * change direction of adjustement from Potis, roteate potis
    * update top view of board acc rotated poti
    * move potis 1mm to bottom
    [LED-driver-Board.kicad_pcb, LED-driver-Board.kicad_sch]
2025-09-23 Update Mobiflight library (#43)
    * add used footprints, add symbol library
    * add used symbols/footprints
    * add picture to footprint lib path
    * add description for including symbol and footprint libraries
    * additonal symbols, footprints and 3D files. Update readme
    * ignore *.bak, e.g. from libraries
    * add MUX symbol and used 6 pin JST connector symbol
    * adding polarized L for RP2350
    * clean up 3D Files .-Step folder. PNGs deleted, 3D files to new folder '3D Files'
    [Coil_RP2350_AOTA-B201610S3R3-101-T.step, Encoder Dual Axis With Button EC11EBB24C03.step, Encoder Single Axis With Button EC11M 25mm.step, Potentiometer_Bochen_3362P-1-502.step, Potentiometer_Bourns_3314j-1-103e.stp, RP2350A-QFN60.step, RP2350B-QFN80.step, SMD Button K2-1808SN-A4SW-01.step]
2025-10-14 Update all boards to KiCad 9.0 (#44)
    * update dimmer board to KiCad version 9
    * update dual encoder board to KiCad version 9
    * update input shifter board, start numbering with zero instead one
    * update MAX7219 breakout board to KiCad version 9
    * add 3 pol JST connector
    * updatge template to KiCad version 9
    * update potentiometer board to KiCad version 9, use JST connector from MF lib
    * update 6pin JST connector
    * update prototyping board to KiCad version 9
    * update symbols on dimmer board, fixed DRC
    * update symbols from MAX7219 breakout board
    * add Screw Terminalblocks to footprint lib and 3D models
    * use screw terminals from MF lib
    * fixed outline of Potentiometer board
    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
    [Degson_ScrewTerminal_DG301-5.0-02.stp, Degson_ScrewTerminal_DG301-5.0-04.stp, LEDs.kicad_sch, MAX7219-breakout-board.kicad_pcb, MAX7219-breakout-board.kicad_sch, active_parts.kicad_sch, dimmer-board.kicad_pcb, dimmer-board.kicad_sch]
2025-10-22 everything routed
    [mf-breakout-74hc4067-smd.kicad_pcb, mf-breakout-74hc4067-smd.kicad_sch]
2025-11-20 add 7Segment driver board
    [7segment-driver-board-CuBottom.gbr, 7segment-driver-board-CuTop.gbr, 7segment-driver-board-EdgeCuts.gbr, 7segment-driver-board-MaskBottom.gbr, 7segment-driver-board-MaskTop.gbr, 7segment-driver-board-NPTH.drl, 7segment-driver-board-PTH.drl, 7segment-driver-board-SilkBottom.gbr]
2025-11-20 update marking on back side
    [7segment-driver-board.kicad_pcb]
2025-11-20 better routing for handsoldering connector on backside
    [7segment-driver-board.kicad_pcb]
2025-11-20 improved routing, fixed wrong marking
    [7segment-driver-board-CuBottom.gbr, 7segment-driver-board-CuTop.gbr, 7segment-driver-board-EdgeCuts.gbr, 7segment-driver-board-MaskBottom.gbr, 7segment-driver-board-MaskTop.gbr, 7segment-driver-board-NPTH.drl, 7segment-driver-board-PTH.drl, 7segment-driver-board-SilkBottom.gbr]
2025-11-20 better folder structure
    [7segment-driver-board-CuBottom.gbr, 7segment-driver-board-CuTop.gbr, 7segment-driver-board-EdgeCuts.gbr, 7segment-driver-board-MaskBottom.gbr, 7segment-driver-board-MaskTop.gbr, 7segment-driver-board-NPTH.drl, 7segment-driver-board-PTH.drl, 7segment-driver-board-SilkBottom.gbr]
2025-11-21 add Pico boards
    [PicoMicro.kicad_pcb, PicoMicro.kicad_sch, RP2350A.kicad_sch, RP2350B.kicad_sch, picomega.kicad_pcb, picomega.kicad_sch, picomega.sch, piconano.kicad_pcb]
2025-11-21 add symbols and footprints for Pico boards
2026-05-14 update lib acc. main, update PicoMocro to KiCad V10
    [PicoMicro.kicad_pcb, PicoMicro.kicad_sch, RP2350A.kicad_sch]
2026-05-15 update PicoMega to KiCad version 10
    [RP2350B.kicad_sch, picomega.kicad_pcb, picomega.kicad_sch]
2026-05-16 add rotary switch connection kit board and SR16 components to library
    [SR16.STEP, X27-168.step, rotary-switch-board.kicad_pcb, rotary-switch-board.kicad_sch, rotary-switch-board.step]
2026-05-16 fix export path in project file (this board was derived from potentiometer board)
2026-05-16 fix stale sheet naming in footprint
2026-08-03 add rotary switch connection kit board and SR16 components to library (#77)
    * add rotary switch connection kit board and SR16 components to library
    * Potential fix for pull request finding
    * fix path separator to more universal style
    * fix export path in project file (this board was derived from potentiometer board)
    * fix stale sheet naming in footprint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
    [SR16.STEP, X27-168.step, rotary-switch-board.kicad_pcb, rotary-switch-board.kicad_sch, rotary-switch-board.step]
